phoxes/daPhox/daPhox.png

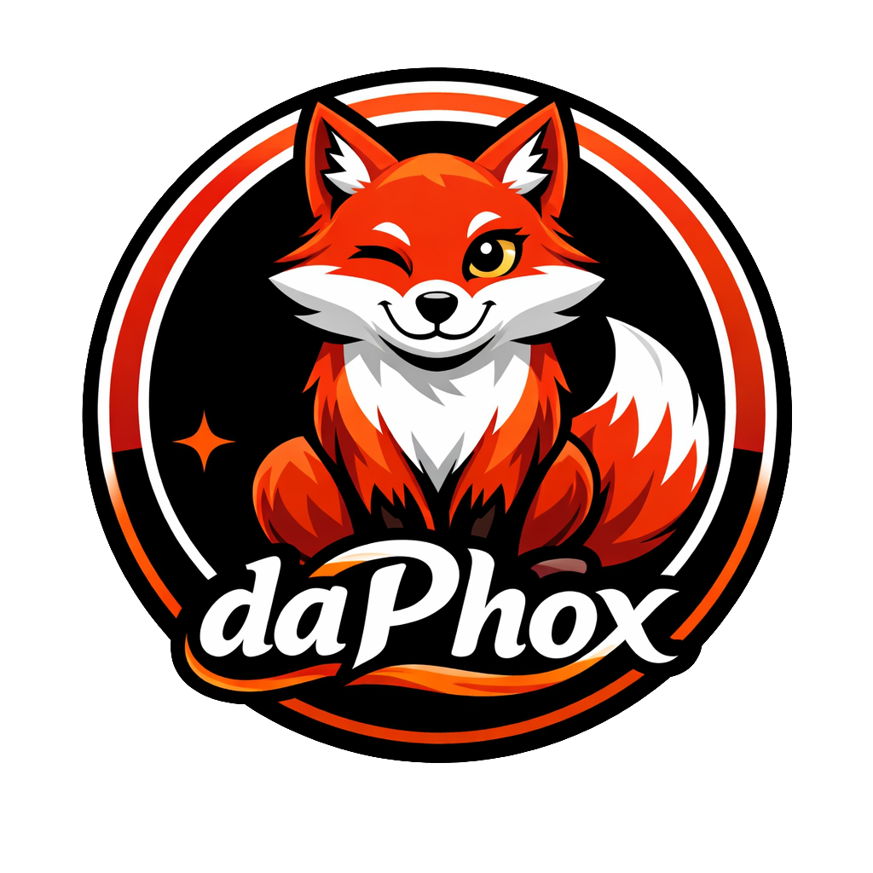
daPhox.png
