phoxes/daPhox/display-build/stl/05_pir_fit_gauge.stl

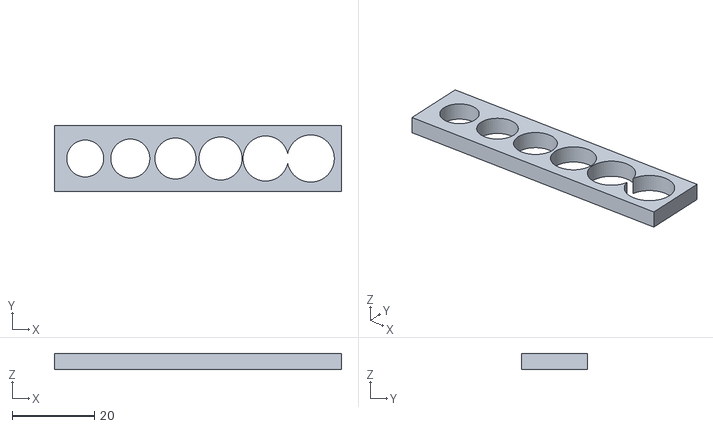
[picture p2: CAD file, 2026-11-07]
display-build/stl/05_pir_fit_gauge.stl
70.0 x 16.0 x 4.00
