phoxes/daPhox/display-build/stl/04_cable_clip_x8.stl

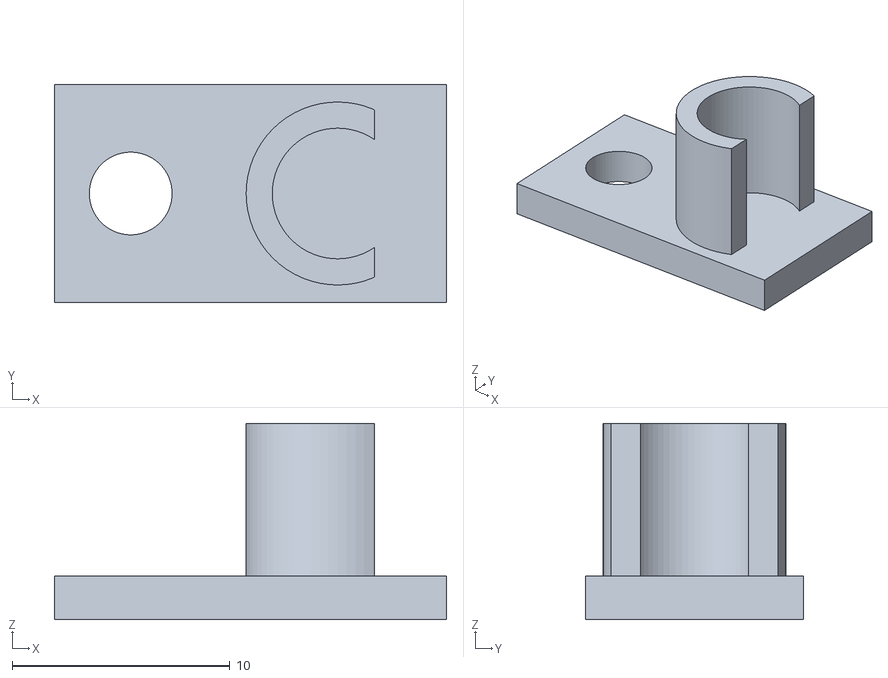
[picture p3: CAD file, 2026-11-07]
display-build/stl/04_cable_clip_x8.stl
18.0 x 10.0 x 9.00
