phoxes/daPhox/display-build/stl/06_fan_gpio_grille.stl

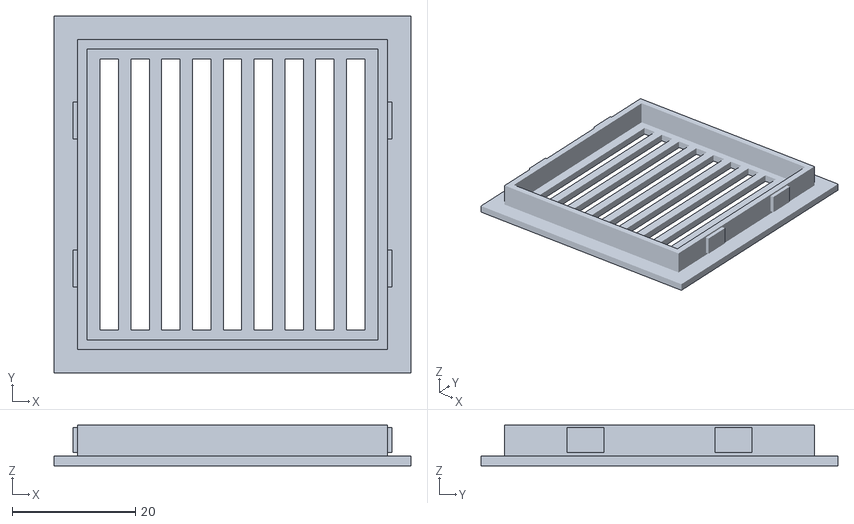
[picture p4: CAD file, 2026-11-07]
display-build/stl/06_fan_gpio_grille.stl
58.0 x 58.0 x 6.60
