phoxes/daPhox/display-build/stl/01_pi5_mount_plate.stl

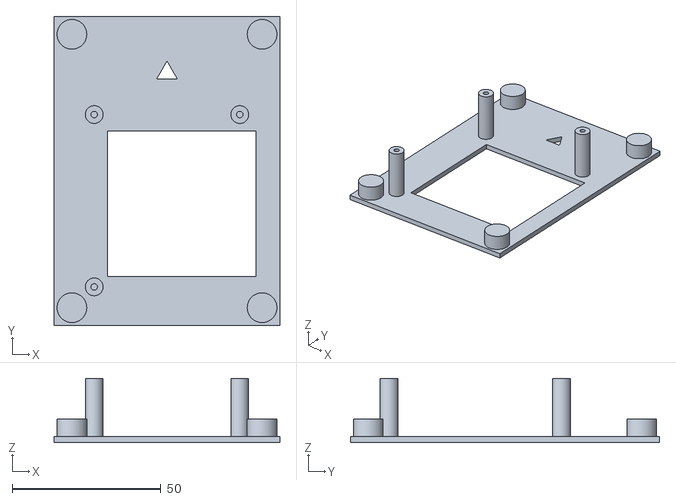
[picture p5: CAD file, 2026-11-07]
display-build/stl/01_pi5_mount_plate.stl
76.0 x 104.0 x 21.6
