phoxes/daPhox/display-build/stl/02_glass_press_block_x6.stl

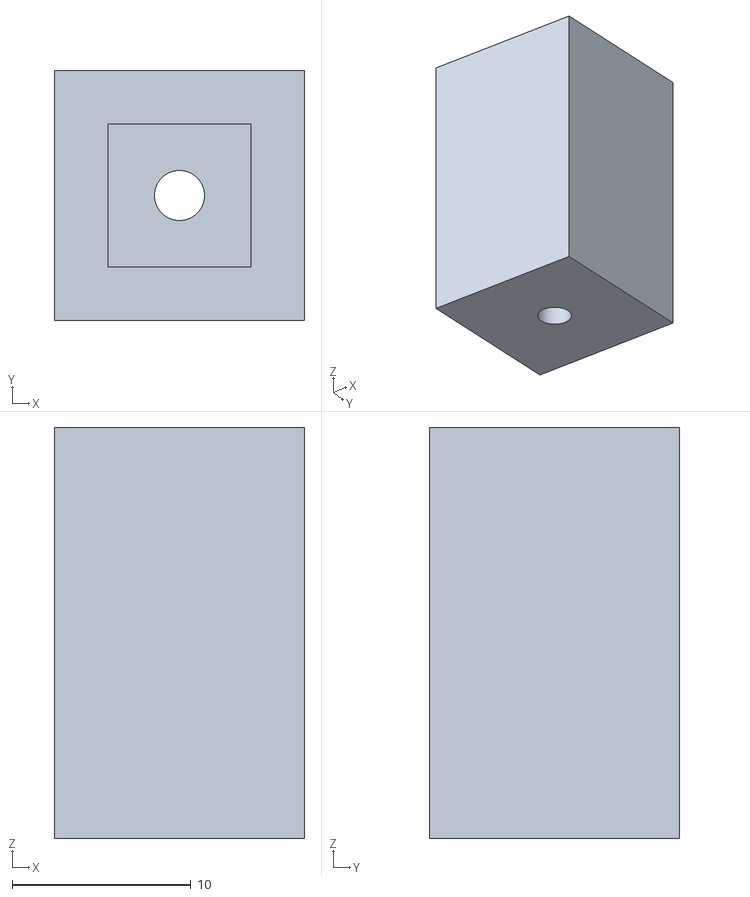
[picture p6: CAD file, 2026-11-07]
display-build/stl/02_glass_press_block_x6.stl
14.0 x 14.0 x 23.0
