phoxes/daPhox/display-build/stl/03_respeaker_cover.stl

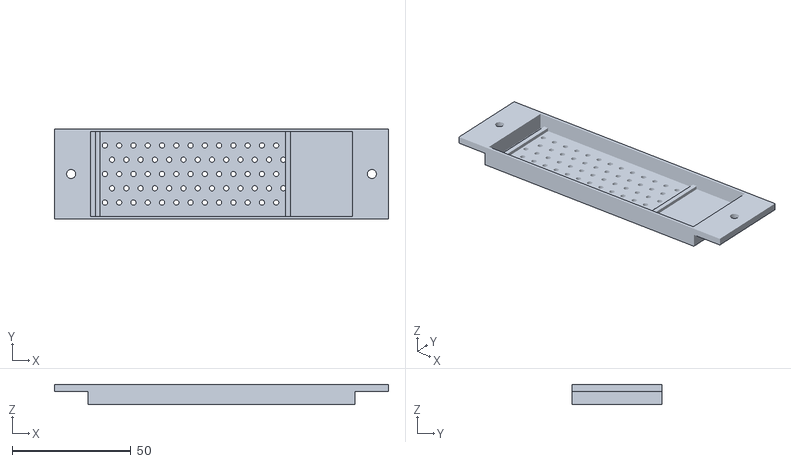
[picture p7: CAD file, 2026-11-07]
display-build/stl/03_respeaker_cover.stl
140.4 x 38.0 x 8.60
