phoxes/daPhox/display-build/index.html

Shop manual · Raspberry Pi 5 · 15.6″ QLED

# daPhox Wall Display Build

A cedar-framed weather screen that hangs flush on the wall, wakes when someone walks up, and listens for “Hey daPhox.” Every part you bought, where it goes, and how to wire it.

⛶ Full screenKeep screen awake

16-9/16″ × 10-13/16″Outside of frame

1-3/4″Total depth, back panel included

1-1/4″ faceCedar rail width seen from the front

2 cordsRun inside the wall to an outlet

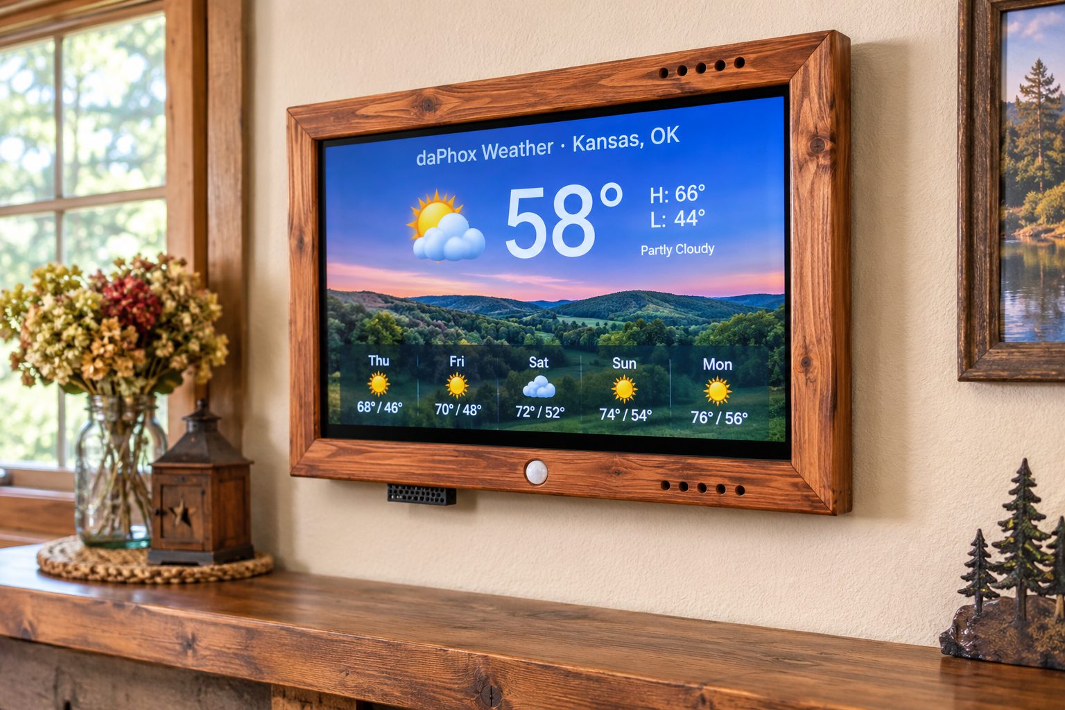
[picture p8: display-build/img/p_hero.jpg]
Finished cedar-framed weather display on a living room wall
 AI picture

The finished display on the wall.

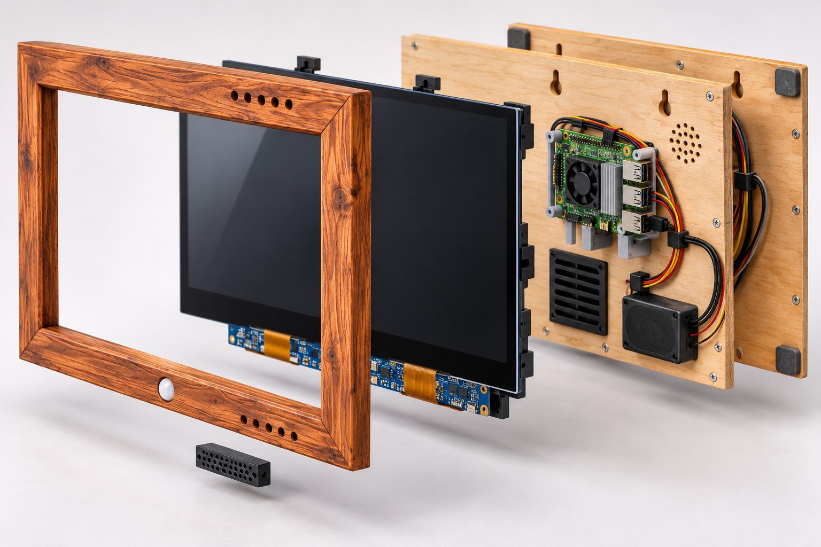
[picture p9: display-build/img/p_exploded.jpg]
Exploded view of frame, screen and back panel with electronics
 AI picture

How it stacks: frame, screen, back panel with the electronics. The picture shows two back panels and extra vent holes; the build has one panel.

1

## Check your parts

Everything you ordered, plus what's still needed.

### You have

- Waveshare 15.6″ QLED touch display (bare glass panel)
- Vemico Raspberry Pi 5 8GB kit (Active Cooler + 27W supply)
- ReSpeaker Lite USB 2-mic array
- Adafruit Mini PIR BS612 (#5578)

### Still to buy

- Seeed Mono Enclosed Speaker 4Ω 5W (#114993346), on Amazon (https://www.amazon.com/Mono-Enclosed-Speaker-High-Performance-ReSpeaker/dp/B0G18N3KSY) Copy link or DigiKey (https://www.digikey.com/en/products/detail/seeed-technology-co-ltd/114993346/24814470)
- microSD card, 64GB, A2 (SanDisk Extreme or Samsung EVO Plus)
- Micro-HDMI to HDMI cable, 1 ft, right-angle micro end · Amazon (https://www.amazon.com/clp/B0DS9NPXLN) Copy link
- USB-A to Micro-USB cable, 1 ft (touch) · Amazon (https://www.amazon.com/Cable-Matters-MicroUSB-Charging-Connector/dp/B0FXVHW6XD) Copy link
- USB-A to USB-C cable, 1 ft (ReSpeaker) · Amazon (https://www.amazon.com/Umefly-USB-C-Cable/dp/B0BLXD4X4G) Copy link
- Female-to-female jumper wires, 20 cm (6 needed) · Amazon (https://www.amazon.com/ELEGOO-Dedicated-Multicolored-Male-Header-Connections/dp/B0H6F428L1) Copy link
- M2.5 × 6 mm screws (4), or an M2.5 assortment · Amazon (https://www.amazon.com/GeeekPi-Standoffs-Assortment-Box%EF%BC%8CMale-Female-Screwdriver/dp/B07PHBTTGV) Copy link
- Cedar 2×4, 8 ft: straight, few knots
- 1/4″ plywood, 2 × 2 ft handy panel
- #6 flat-head wood screws: 1/2″ (14) and 3/4″ (8)
- 1/8″ foam tape, 1″ rubber grommet, 4 felt bumpers (3/8″ thick)
- Keyhole router bit (3/8″), 2 pan-head screws + wall anchors
- 2 brush-style wall pass-through plates (low-voltage)
- Wood glue, Danish oil or tung oil, wire brush wheel for a drill

Amazon linksOn your Android phone, the Amazon links open in Chrome instead of the Amazon app. If one opens somewhere else, tap Copy link and paste it into Chrome.

Check the boxWaveshare usually includes a 12V power supply, an HDMI cable and a touch USB cable with the screen. Use theirs if they fit. The 1 ft cables above keep the inside tidy.

2

## Print the parts

Kobra X, PLA. Tap a file name below to download it.

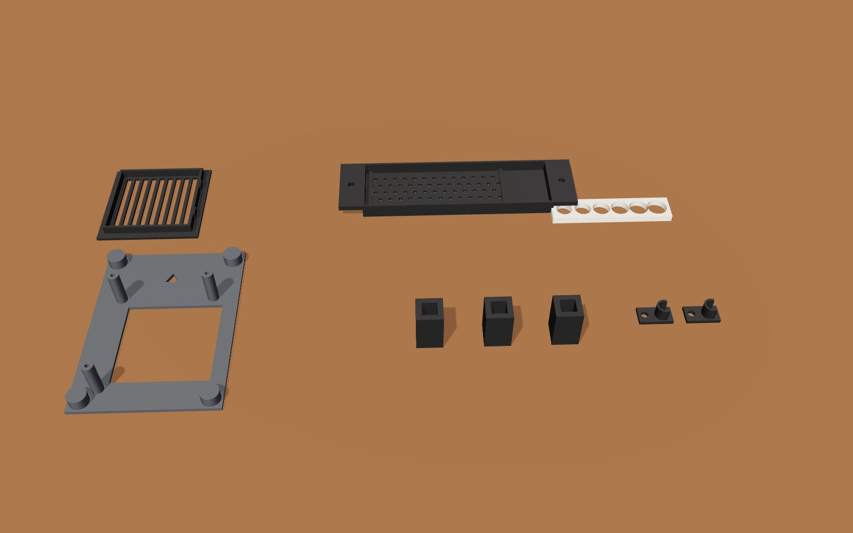
[picture p10: display-build/img/parts.jpg]
Five printed parts on a workbench: Pi mounting plate, six press blocks, ReSpeaker cover, PIR fit gauge and cable clips
 162345

# | File | Qty | What it does

1 | 01_pi5_mount_plate.stl | 1 | Holds the Pi on tall posts with its fan facing the wall. Its square window is your cutting template for the back-panel vent. The little arrow points to the top of the frame.
2 | 02_glass_press_block_x6.stl | 6 | Press the screen against the front lip when the back panel goes on.
3 | 03_respeaker_cover.stl | 1 | Hides the mic board under the bottom rail. The grille faces down.
4 | 04_cable_clip_x8.stl | 8 | Keep cables flat against the back panel.
5 | 05_pir_fit_gauge.stl | 1 | Holes from 9 to 11.5 mm. Find the one that fits the PIR cap snugly, then use that drill bit.
6 | 06_fan_gpio_grille.stl | 1 | Press-fits into the 2″ vent in the back panel. Pop it out to reach the Pi's sensor pins without opening the frame.

- Settings: 0.2 mm layers, 3 walls, 20% infill, no supports. Print the cover and grille with the grille side down, and the plate flat with its posts up.
- Print the PIR gauge first. You need its answer before drilling the frame.
- Black PLA disappears inside the frame. The cover is the only part that shows, so pick a color that matches your finish.

3

## Bench-test the electronics

Make sure everything works before it goes in the wood.

- On your Mac, install Raspberry Pi Imager. Choose Raspberry Pi 5 → Raspberry Pi OS (64-bit) → your microSD. In settings, set hostname daphox, your Wi-Fi and a username, and turn on SSH.
- Peel the Active Cooler's thermal pads and press it onto the Pi. Clip its fan cable into the FAN connector.
- Lay the screen face-down on a towel. Connect Pi HDMI 0 (the micro-HDMI port next to USB-C power) to the screen's HDMI port. Plug the touch cable into a Pi USB port.
- Power the screen (12V) first, then the Pi (27W USB-C). The desktop should appear, and tapping should work.
- Plug the ReSpeaker into a Pi USB port, and the speaker into the ReSpeaker's speaker connector. Run the sound test from step 11.

CarefulThe screen is bare glass with the driver board exposed on the back. Pick it up by the glass edges only, and never press on the ribbon cables.

4

## Mill the cedar rails

Table saw. One 8 ft 2×4 makes all four rails, with a spare strip left over.

- Rip the 2×4 into two strips 1-1/4″ wide, keeping the full 1-1/2″ thickness. The 1-1/4″ side is the face you'll see.
- Pick the best-looking face for the front, and mark the inside edge and the back on each strip.
- Rabbet, cut 1: strip front-face down with the outside edge against the fence. Blade height 1-1/4″, fence 1″ from the far side of the blade.
- Rabbet, cut 2: stand the strip on its inside edge with the front face against the fence. Blade height 1/4″, fence 1/4″ from the near side of the blade. The 1/4″ × 1-1/4″ waste strip falls free on the open side.
- Test the rabbet with a scrap. The screen (5.6 mm thick) should sit flat on the 1/4″ lip.

SafetyBoth cuts leave the waste on the side away from the fence, so it can't get trapped and kick back. Use a push stick, because these strips are narrow.

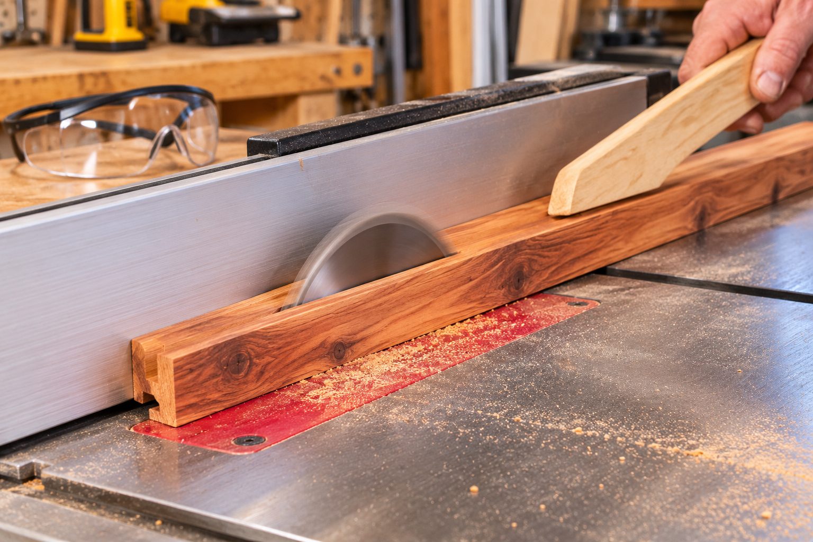
[picture p11: display-build/img/p_saw.jpg]
Cedar strip on a table saw with a push stick, rabbet being cut
 AI picture

Cutting the rabbet with a push stick.

5

## Miter, dry-fit, glue

Miter saw at 45°. Measure the long point on the outside edge.

- Cut two rails at 16-9/16″ and two at 10-13/16″, long point to long point, with the rabbet facing in. Cut a test pair on scrap first to check 90°.
- Dry-fit the screen. Tape the corners with painter's tape, lay the frame face-down, and drop the screen in. It should have about 1/32″ of play all around. Trim if it's tight.
- Glue the miters and clamp with a band clamp. Check the diagonals are equal (square). Optional: two 23-gauge pins per corner.
- Let it dry for 1 hour, then scrape off the glue squeeze-out inside the pocket. Dried glue there will stop the screen from sitting flat.

Screen orientationThe glass has a thin black border at the top (7 mm) and a wider one at the bottom (21 mm). Face-down in the frame, the blue driver board should sit in the lower half.

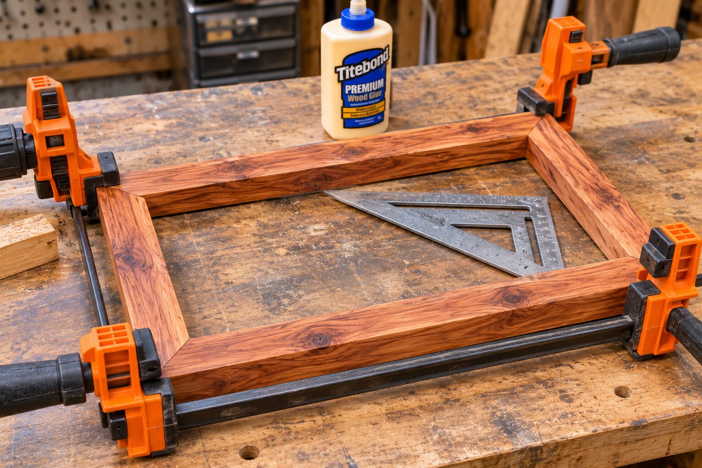
[picture p12: display-build/img/p_glue.jpg]
Mitered cedar frame in clamps with a square and wood glue
 AI picture

Glue-up: clamps snug, check that it's square.

6

## Drill holes and route keyholes

Draw a center line across the top and bottom rails first. Every position is measured from it, as seen from the front.

Hole | Where (from center, viewed from front) | Size / depth
PIR sensor | Bottom rail front face, on center, 1/2″ up from the bottom edge | Gauge bit · straight through 1-1/2″
PIR wire channel | Back face of the bottom rail, from the PIR hole up into the pocket | 3/8″ wide × 1/4″ deep (chisel)
Mic cable | Underside, 1-1/4″ left, centered front-to-back | 1/2″ · up into pocket (1″)
Mic cover screws | Set the printed cover with its right end 3/8″ left of center, then mark through its 2 holes | 3/32″ pilot · 1/2″ deep
Intake vents (8) | Underside, 3-1/16″, 3-9/16″, 4″, 4-1/2″ right; rows 11/16″ and 1-1/4″ from the front face | 3/8″ · up into pocket
Exhaust vents (12) | Top edge, 2-3/8″, 2-15/16″, 3-9/16″, 4-1/8″, 4-3/4″, 5-5/16″ right; rows 11/16″ and 1-1/4″ from the front face | 3/8″ · down into pocket
Keyholes (2) | Back of the top rail, 5-1/8″ each side of center, plunged 11/16″ down from the top edge, slot toward the top | 3/8″ keyhole bit · 3/8″ deep · 5/16″ slot

- Use a brad-point bit and a backer board to keep the cedar from tearing out. Drill the PIR hole slowly; a drill-press is ideal.
- Check the PIR cap's fit in the hole. It should push in snugly with only the white dome showing.
- Route the keyholes. Test on scrap: a pan-head screw should slide in and lock at the top of the slot.

How it breathesThe Pi faces the wall. Its fan pulls cool room air through the 2″ grille in the back panel; the 3/8″ felt bumpers leave a gap behind the frame for that air. Warm air rises out the top vents, and the bottom vents let more air in.

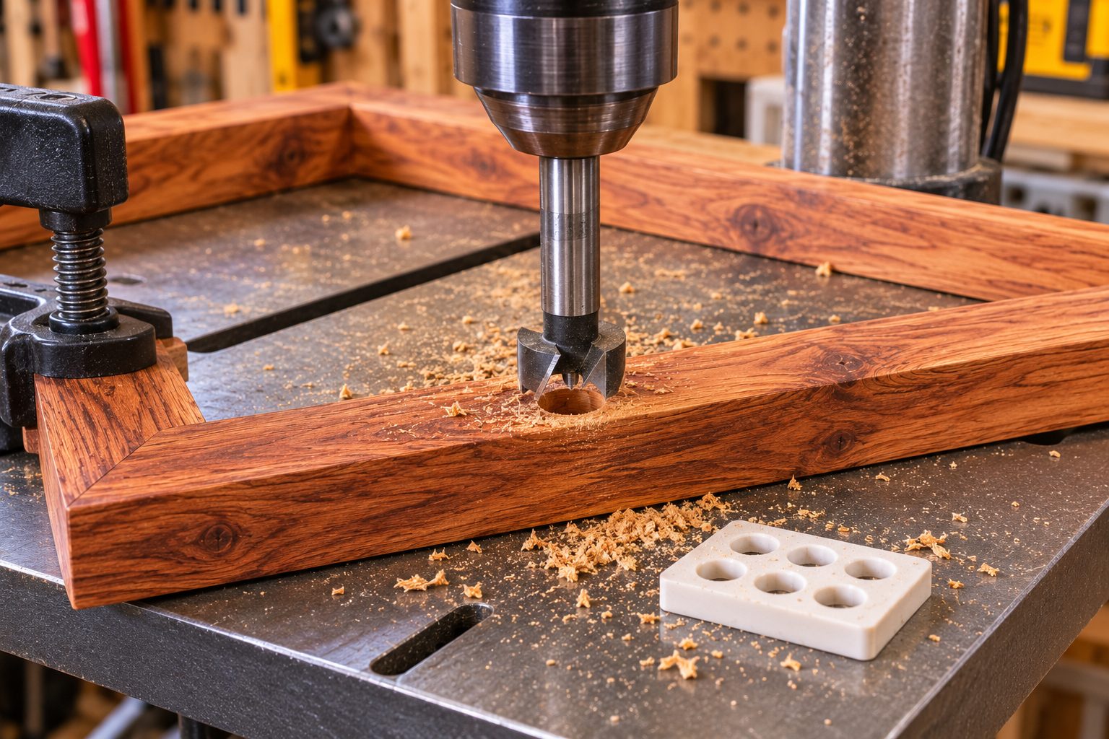
[picture p13: display-build/img/p_drill.jpg]
Drill press boring a hole in the cedar frame next to the printed gauge
 AI picture

Drilling with the printed gauge on hand. Your sensor hole goes into the front face of the bottom rail, not the top as shown.

7

## Rustic texture and finish

Brush, ease, oil.

- Run a nylon or brass wire wheel on a drill with the grain over the face and sides. It scrubs out the soft wood and leaves the grain raised.
- Ease every outside edge with 120-grit, then lightly sand the face at 180 to knock off fuzz. Don't sand the texture away.
- Optional: pass a propane torch quickly over the face, then brush again for darker grain lines.
- Wipe on Danish oil or tung oil (keeps cedar's natural red), wait 15 min, then wipe off. Two coats. Keep oil out of the pocket.
- Let it cure 3 days before closing in the electronics, so oil fumes don't coat the screen.

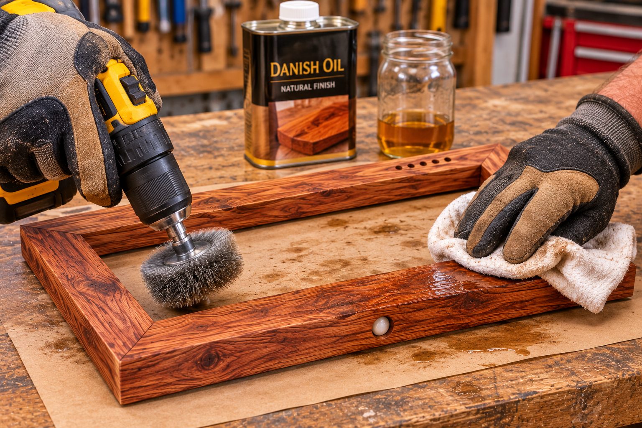
[picture p14: display-build/img/p_finish.jpg]
Wire-brushing and oiling the cedar frame
 AI picture

Wire-brush along the grain, then wipe on Danish oil.

8

## Make the back panel

1/4″ plywood, cut to 16-9/16″ × 10-13/16″. All positions below are as seen from the back.

Item | Position from panel center (seen from back)
Grommet hole, 1″ | 1-9/16″ left, 13/16″ up
Pi plate (inside face) | Centered 3-7/8″ left, 2-1/4″ down, arrow toward the top. Its 4 screws go in from the back
Fan / GPIO vent, 2″ square | Centered 4-1/16″ left, 2-11/16″ down. Trace it from the plate's window
Speaker (inside face) + grille | Centered 5-1/2″ right, 2-3/16″ up. 13 holes, 3/16″, in a 1-1/8″ circle
Press blocks (6, inside face) | 4 corners 6-11/16″ left/right and 3-15/16″ up/down. 1 top-center (4-1/8″ up). 1 at 3/4″ left, 4-1/8″ down. Keep blocks off the screen's ribbon cables
Keyhole windows | Line up with the routed keyholes: drill 1/2″ at the entry, file a 1/4″ slot toward the top

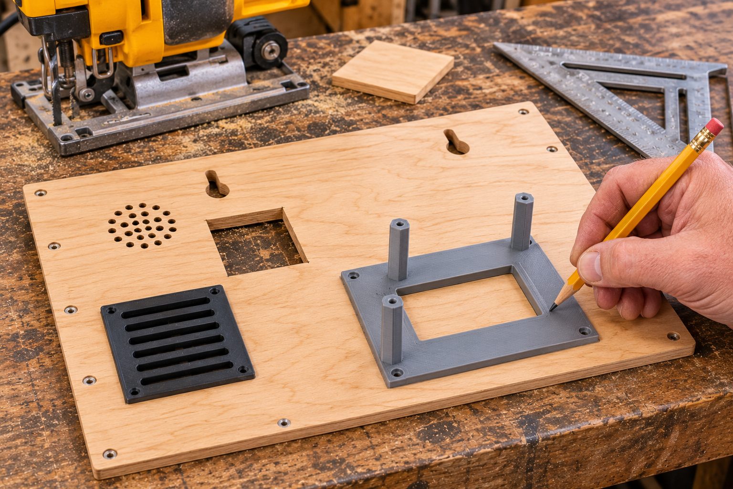
[picture p15: display-build/img/p_panel.jpg]
Tracing the printed Pi plate window onto the plywood back panel
 AI picture

Tracing the plate's window to mark the 2″ vent. The picture's layout is simplified; follow the diagram above.

- Cut the panel, then drill and countersink the 8 edge screw holes. Drill the grommet, speaker grille and keyhole windows.
- Turn the panel inside face up. Set the Pi plate posts-up with its arrow toward the top, centered 3-7/8″ right and 2-1/4″ below center (it reads "right" from this side). Mark its 4 corner holes and trace the inside of its window.
- Cut the traced 2″ square vent: drill a 3/8″ hole in each corner, then jigsaw or coping-saw between them. Sand the edges until the printed grille presses in snugly from the outside.
- Screw the plate on from the outside: 4 × #6 × 1/2″ flat-heads into its corner bosses.
- Screw the 6 press blocks on from the outside (#6 × 1/2″). Stick 1/8″ foam tape on each block's tip.
- Stick the speaker face-down over the grille with VHB tape or a bead of hot glue around its edge.
- Fit the rubber grommet, add the 3/8″ felt bumpers to the outside corners, and press the grille into the vent.

9

## Wiring

Six jumpers for the motion sensor. Everything else is a plug-in cable.

### Complete wiring diagram

Every part and every connection. Lines are colored by type, and the six sensor wires use their own colors.

### Motion sensor close-up

PIR leg | Name | Goes to Pi pin | Wire
1 | SENS (sensitivity) | Pin 9 · GND | brown
2 | OEN (enable) | Pin 17 · 3.3V | orange
3 | VSS (ground) | Pin 6 · GND | black
4 | VDD (power) | Pin 1 · 3.3V | red
5 | REL (motion signal) | Pin 11 · GPIO17 | yellow
6 | ONTIME | Pin 14 · GND | gray

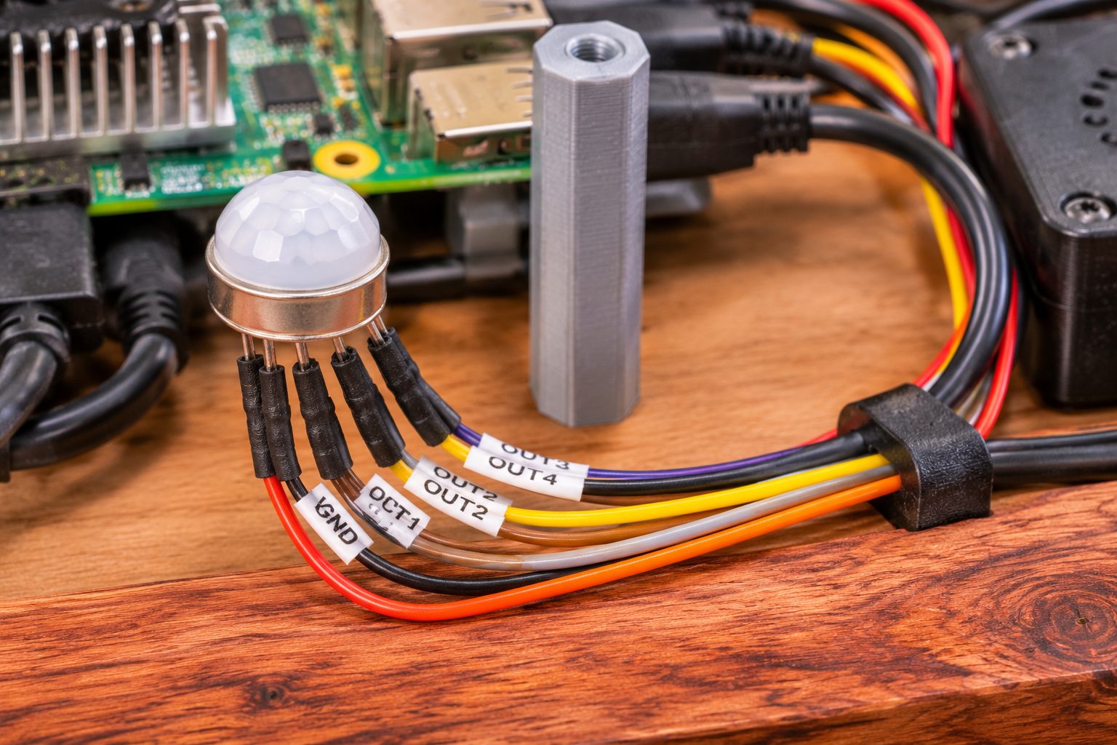
[picture p16: display-build/img/p_pirwire.jpg]
Close-up of the motion sensor with six colored jumpers on its legs
 AI picture

Jumpers slid onto the sensor legs with heat-shrink. Ignore the label tags in this picture. Label yours with the leg names from the table above.

3.3V onlyNever use the Pi's 5V pins (2 and 4) for this sensor. Leg 1 is the leg beside the little metal tab on the sensor's can. Count clockwise from there, looking at the legs.

Loose legsThe PIR legs are thin (0.45 mm), so jumpers can slip off. Slide each jumper on, then add a small piece of heat-shrink or a dab of hot glue. Keep the six legs from touching each other.

### Plug-in connections

From | To | Cable
Pi HDMI 0 (next to USB-C) | Screen HDMI port | 1 ft micro-HDMI → HDMI
Pi USB 2 port (black) | Screen Touch micro-USB port | 1 ft USB-A → micro-USB
Pi USB 2 port (black) | ReSpeaker USB-C | 1 ft USB-A → USB-C (through the 1/2″ rail hole)
ReSpeaker speaker connector | Speaker | Speaker's own lead (through the same hole)
Screen DC jack | 12V adapter | Out through the grommet
Pi USB-C | 27W Vemico supply | Out through the grommet
Active Cooler | Pi FAN connector | Its own short lead

Voice tipThe speaker plugs into the ReSpeaker, not the screen. The ReSpeaker then knows what daPhox is saying and can filter its own voice out while listening for “Hey daPhox.”

10

## Install everything in the frame

Frame face-down on a towel. View below is from the back, with the back panel off.

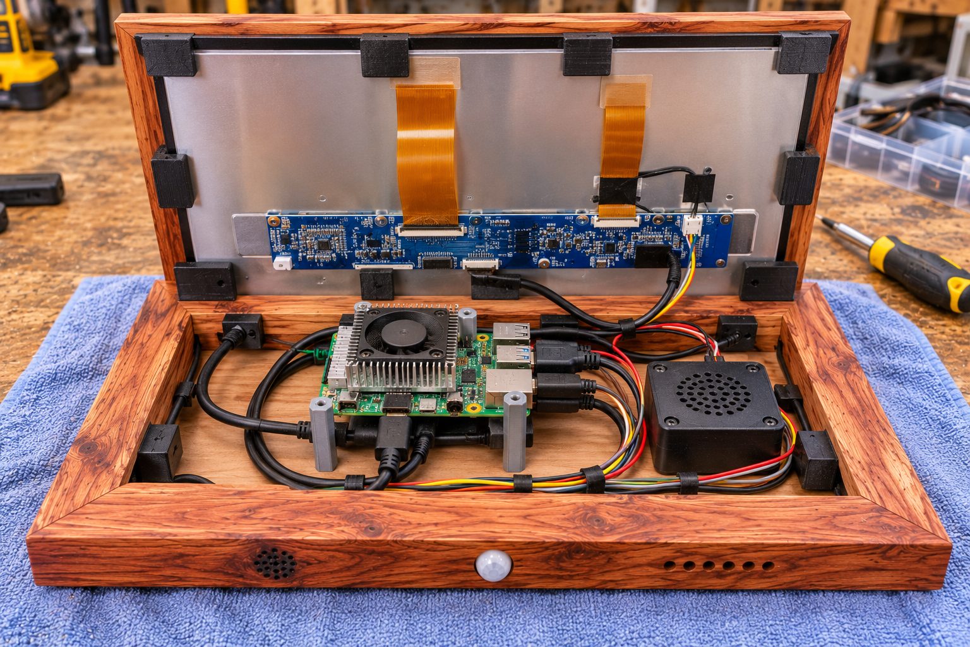
[picture p17: display-build/img/p_inside.jpg]
Frame open on a towel with the Pi, speaker, cables and press blocks inside
 AI picture

Everything connected before closing up. In the real build the Pi's fan faces the back panel, and the parts mount on the back panel.

- Clean the glass inside and out. Lay the screen face-down in the pocket, driver board toward the bottom rail.
- PIR: snap the white cap onto the sensor, label its 6 legs, and attach the jumpers. Feed the wires back through the hole from the front, and press the cap in until the dome sits flush with the face. Lay the wires in the channel.
- Mic: plug the USB-C cable into the ReSpeaker. Feed the cable and the speaker lead up through the 1/2″ hole, then plug the speaker into the ReSpeaker. Set the board in the cover, mics facing the grille, and screw the cover on.
- Mount the Pi on the plate's 3 posts (M2.5 × 6 mm) with the fan facing the back panel. USB ports point to the top, micro-HDMI faces the screen's driver board, and the GPIO pins sit over the vent.
- Hold the back panel upright behind the frame like an open book. Connect everything from the wiring diagram: HDMI, touch, ReSpeaker USB, and the six PIR jumpers.
- Feed the 12V and USB-C power cords through the grommet. Plug them in and test before closing: screen on, touch works, wave at the PIR.
- Later access: pop the grille out of the back to check or move the sensor jumpers. GPIO pins 1–18 sit right behind it.
- Clip the cables down, fold the panel closed, and drive the 8 edge screws (#6 × 3/4″). The press blocks will snug the screen against the lip.

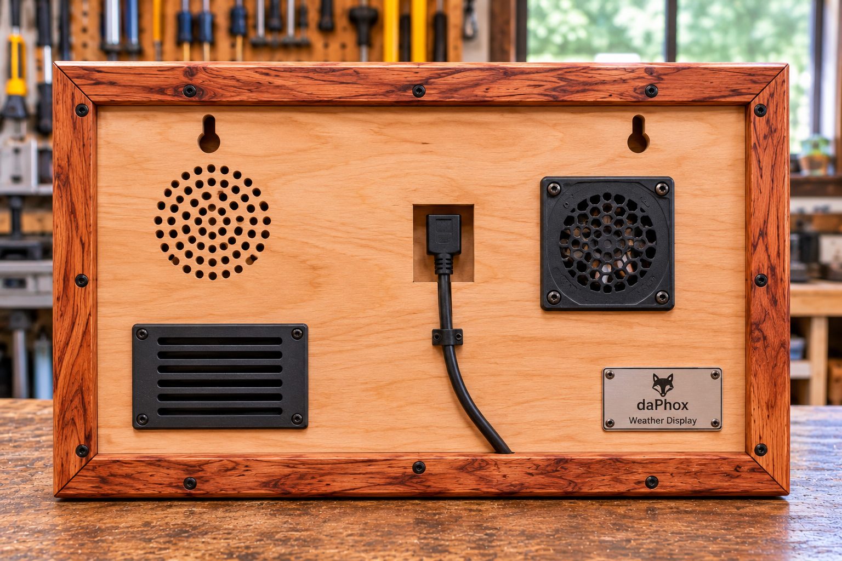
[picture p18: display-build/img/p_back.jpg]
Back of the finished frame with keyholes, grilles and a cord
 AI picture

The finished back. The nameplate is a nice touch to add. Use the back-panel diagram in step 8 for the real hole layout.

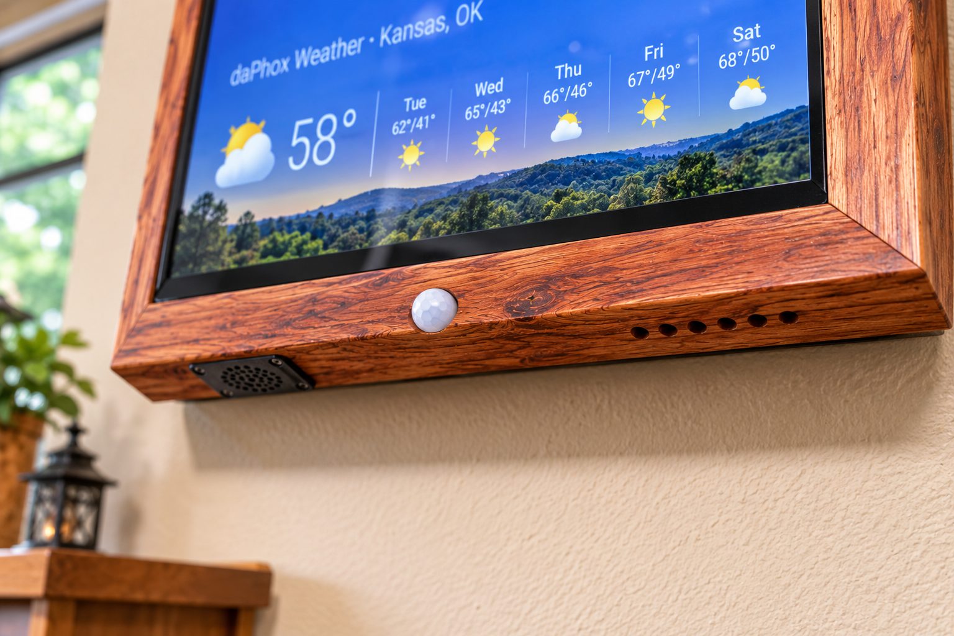
[picture p19: display-build/img/p_under.jpg]
Close-up of the bottom rail with the motion sensor dome, mic cover and vent holes
 AI picture

Bottom rail: sensor dome on the front face, mic cover underneath.

11

## Test the sensor, mic and speaker

Open Terminal on your Mac and connect with ssh daphox.local, or use a keyboard on the Pi.

### Motion sensor

python3 -c "from gpiozero import MotionSensor; from signal import pause
p = MotionSensor(17)
p.when_motion = lambda: print('motion')
p.when_no_motion = lambda: print('clear')
pause()"

Walk past. You should see motion, then clear about 2 seconds after you stop. Press Ctrl+C to quit.

### Screen off and on

WAYLAND_DISPLAY=wayland-0 wlr-randr --output HDMI-A-1 --off
WAYLAND_DISPLAY=wayland-0 wlr-randr --output HDMI-A-1 --on

With no signal, the Waveshare goes to standby. The motion code in your daphox-display repo will run these for you.

### Mic and speaker

arecord -l                      # find the ReSpeaker's card number, e.g. card 2
arecord -D plughw:2,0 -f S16_LE -r 16000 -c 2 -d 5 test.wav
aplay -D plughw:2,0 test.wav
- PIR prints motion when you walk up
- Screen turns off and back on
- You hear your own voice played back through the speaker
- Pi temperature stays under 70 °C after an hour: vcgencmd measure_temp

Dogs setting it off?The sensor is at full sensitivity now (leg 1 to ground). Leg 1 can take a small resistor pair to make it less sensitive. Ask me for the exact values when you get there.

12

## Hang it

Two screws, two wall plates, no electrician.

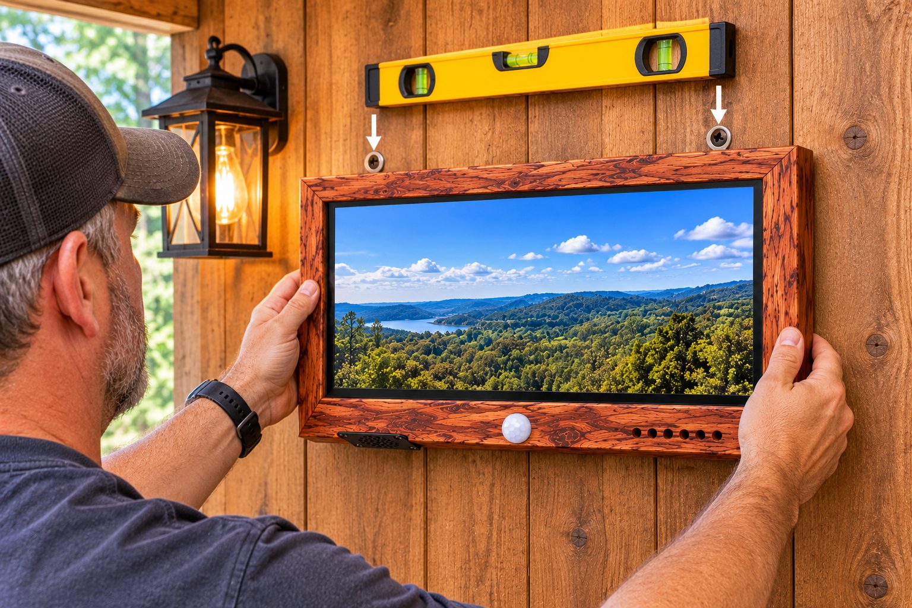
[picture p20: display-build/img/p_hang.jpg]
Hanging the display on two screws with a level
 AI picture

Hooking the keyholes over the two screws, checking level.

- Pick a height where the screen's center is at eye level, usually 57–60″ from the floor. Keep it within about 10 ft of where people talk, for the mic.
- Measure from the frame's top edge down to the top of a keyhole slot. Mark two screws that far below where you want the top of the frame, 10-1/4″ apart and level. Use anchors (or hit a stud), and leave each head about 1/8″ out.
- Mark where the grommet will land. Seen from the front, it's 1-9/16″ right of center and 13/16″ above center of the frame. Cut a hole there for the upper brush plate, and another just above the outlet below.
- Drop the 12V and USB-C cords down inside the wall from the upper plate to the lower plate, and plug the power bricks into the outlet.
- Hook the keyholes over the screws and slide the frame down. The 3/8″ felt bumpers keep it flat and leave the air gap the fan needs.

Only low-voltage in the wallRun only the 12V and USB-C cords inside the wall. Never put a plug-in extension cord inside the wall. If the cords don't reach, use a USB-C (5A) extension and a 3.5 × 1.35 mm DC extension.

NextPi setup, so it starts on boot and recovers after power loss, is step 2 of the build plan in your daphox-display repo. Motion dimming is step 3.

Screen sizes come from Waveshare's 15.6HP-CAPQLED drawing (glass 367.9 × 222.4 mm). PIR legs come from the Senba BS612 datasheet. Pictures are AI-generated illustrations, not real photos. Follow the diagrams and measurements. Measure your actual screen and PIR cap before cutting.

Clear all checkmarks
